MarcinWojewodzic/C2V1_OutDoorWeatherStation/Hardware/PrototymV1_rx/PrototypV1_rx.kicad_pcb

## KiCad design Hardware/PrototymV1_rx/PrototypV1_rx.kicad_pcb (2022-09-23)

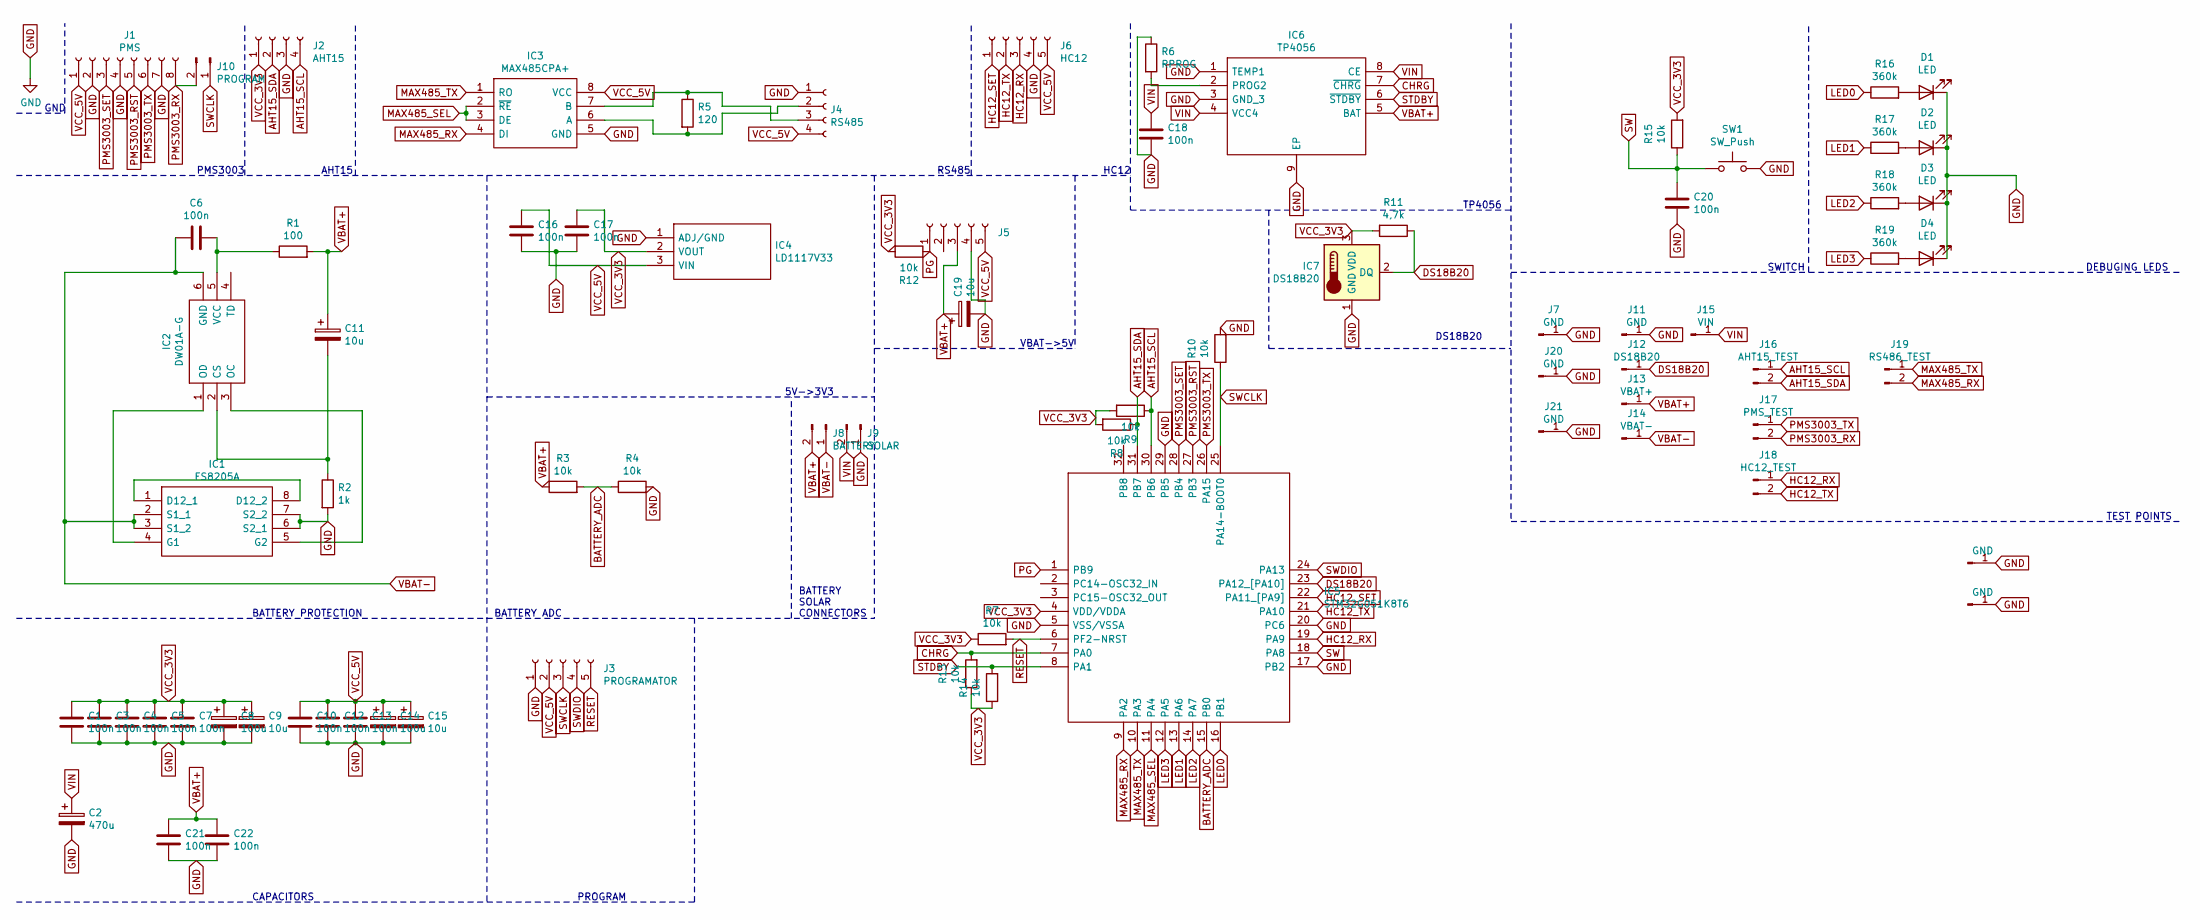
[picture p1: schematic PrototypV1_rx.sch]

Parts:
C1, C3, C4, C5, C6, C7, C10, C12, C13, C16, C17, C18, C20, C21, C22: 100n; C_1206_3216Metric_Pad1.33x1.80mm_HandSolder
C2: 470u; CP_Elec_8x10.5
C8, C14: 100u; CP_Elec_5x5.4
C9, C11, C15, C19: 10u; CP_Elec_4x5.4
D1, D2, D3, D4: LED; D_1206_3216Metric_Pad1.42x1.75mm_HandSolder
IC1: FS8205A; SOP65P640X120-8N; Manufacturer_Part_Number FS8205A
IC2: DW01A-G; SOT95P190X145-6N; Manufacturer_Part_Number DW01A-G
IC3: MAX485CPA+; DIP794W56P254L938H457Q8N; Manufacturer_Part_Number MAX485CPA+; Mouser Part Number 700-MAX485CPA
IC4: LD1117V33; TO255P460X1020X2008-3P; Manufacturer_Part_Number LD1117V33; Mouser Part Number 511-LD1117V33
IC5: STM32G051K8T6; QFP80P900X900X160-32N; Manufacturer_Part_Number STM32G051K8T6; Mouser Part Number 511-STM32G051K8T6
IC6: TP4056; SOIC127P600X175-9N; Manufacturer_Part_Number TP4056
IC7: DS18B20; TO-92_Inline
J1: PMS; PinHeader_1x08_P2.54mm_Vertical
J2: AHT15; PinHeader_1x04_P1.27mm_Horizontal
J3: PROGRAMATOR; PinHeader_1x05_P2.54mm_Vertical
J4: RS485; TerminalBlock_bornier-4_P5.08mm
J5: PinHeader_1x05_P2.54mm_Vertical
J6: HC12; PinHeader_1x05_P2.54mm_Vertical
J7, J11, J20, J21, J23: GND; PinHeader_1x01_P2.54mm_Vertical
J8: BATTERY; PinHeader_1x02_P2.54mm_Vertical
J9: SOLAR; PinHeader_1x02_P2.54mm_Vertical
J10: PROGRAM; PinHeader_1x02_P2.54mm_Vertical
J12: DS18B20; PinHeader_1x01_P2.54mm_Vertical
J13: VBAT+; PinHeader_1x01_P2.54mm_Vertical
J14: VBAT-; PinHeader_1x01_P2.54mm_Vertical
J15: VIN; PinHeader_1x01_P2.54mm_Vertical
J16: AHT15_TEST; PinHeader_1x02_P2.54mm_Vertical
J17: PMS_TEST; PinHeader_1x02_P2.54mm_Vertical
J18: HC12_TEST; PinHeader_1x02_P2.54mm_Vertical
J19: RS486_TEST; PinHeader_1x02_P2.54mm_Vertical
R1: 100; R_1206_3216Metric_Pad1.30x1.75mm_HandSolder
R2: 1k; R_1206_3216Metric_Pad1.30x1.75mm_HandSolder
R3, R4, R7, R8, R9, R10, R12, R13, R14, R15: 10k; R_1206_3216Metric_Pad1.30x1.75mm_HandSolder
R5: 120; R_1206_3216Metric_Pad1.30x1.75mm_HandSolder
R6: RPROG; R_Axial_DIN0309_L9.0mm_D3.2mm_P15.24mm_Horizontal
R11: 4,7k; R_1206_3216Metric_Pad1.30x1.75mm_HandSolder
R16, R17, R18, R19: 360k; R_1206_3216Metric_Pad1.30x1.75mm_HandSolder
SW1: SW_Push; SW_Push_1P1T_NO_6x6mm_H9.5mm
ghj1: GND; PinHeader_1x01_P2.54mm_Vertical

Connections:
AHT15_SCL: IC5.30 (PB6), J2.4, J16.1, R9.1
AHT15_SDA: IC5.31 (PB7), J2.2, J16.2, R8.1
BATTERY_ADC: IC5.15 (PB0), R3.2, R4.1
CHRG: IC5.7 (PA0), IC6.7 (~CHRG), R13.2
DS18B20: IC5.23 (PA12_[PA10]), IC7.2 (DQ), J12.1, R11.1
GND: C1.2, C2.2, C3.2, C4.2, C5.2, C7.2, C8.2, C9.2, C10.2, C12.2, C13.2, C14.2, C15.2, C16.2, C17.2, C18.2, C19.2, C20.2, C21.2, C22.2, D1.1 (K), D2.1 (K), D3.1 (K), D4.1 (K), IC1.6 (S2_1), IC1.7 (S2_2), IC3.5 (GND), IC4.1 (ADJ/GND), IC5.5 (VSS/VSSA), IC5.17 (PB2), IC5.20 (PC6), IC5.29 (PB5), IC6.1 (TEMP1), IC6.3 (GND_3), IC6.9 (EP), IC7.1 (GND), J1.2, J1.4, J1.7, J2.3, J3.1, J4.1, J5.4, J6.4, J7.1, J9.1, J11.1, J20.1, J21.1, J23.1, R2.2, R4.2, R6.1, R10.2, SW1.2, ghj1.1
HC12_RX: IC5.19 (PA9), J6.3, J18.1
HC12_SET: IC5.22 (PA11_[PA9]), J6.1
HC12_TX: IC5.21 (PA10), J6.2, J18.2
LED0: IC5.16 (PB1), R16.1
LED1: IC5.13 (PA6), R17.1
LED2: IC5.14 (PA7), R18.1
LED3: IC5.12 (PA5), R19.1
MAX485_RX: IC3.4 (DI), IC5.9 (PA2), J19.2
MAX485_SEL: IC3.2 (~RE), IC3.3 (DE), IC5.11 (PA4)
MAX485_TX: IC3.1 (RO), IC5.10 (PA3), J19.1
unnamed: C6.2, IC2.5 (VCC), R1.1
unnamed: C11.2, IC2.2 (CS), R2.1
unnamed: D1.2 (A), R16.2
unnamed: D2.2 (A), R17.2
unnamed: D3.2 (A), R18.2
unnamed: D4.2 (A), R19.2
unnamed: IC1.1 (D12_1), IC1.8 (D12_2)
unnamed: IC1.4 (G1), IC2.1 (OD)
unnamed: IC1.5 (G2), IC2.3 (OC)
unnamed: IC3.6 (A), J4.2, R5.2
unnamed: IC3.7 (B), J4.3, R5.1
unnamed: IC6.2 (PROG2), R6.2
PG: IC5.1 (PB9), J5.1, R12.1
PMS3003_RST: IC5.27 (PB3), J1.5
PMS3003_RX: J1.8, J10.2, J17.2
PMS3003_SET: IC5.28 (PB4), J1.3
PMS3003_TX: IC5.26 (PA15), J1.6, J17.1
RESET: IC5.6 (PF2-NRST), J3.5, R7.2
STDBY: IC5.8 (PA1), IC6.6 (~STDBY), R14.2
SW: C20.1, IC5.18 (PA8), R15.1, SW1.1
SWCLK: IC5.25 (PA14-BOOT0), J3.3, J10.1, R10.1
SWDIO: IC5.24 (PA13), J3.4
VBAT+: C11.1, C19.1, C21.1, C22.1, IC6.5 (BAT), J5.3, J8.2, J13.1, R1.2, R3.1
VBAT-: C6.1, IC1.2 (S1_1), IC1.3 (S1_2), IC2.6 (GND), J8.1, J14.1
VCC_3V3: C1.1, C3.1, C4.1, C5.1, C7.1, C8.1, C9.1, C17.1, IC4.2 (VOUT), IC5.4 (VDD/VDDA), IC7.3 (VDD), J2.1, R7.1, R8.2, R9.2, R11.2, R12.2, R13.1, R14.1, R15.2
VCC_5V: C10.1, C12.1, C13.1, C14.1, C15.1, C16.1, IC3.8 (VCC), IC4.3 (VIN), J1.1, J3.2, J4.4, J5.5, J6.5
VIN: C2.1, C18.1, IC6.4 (VCC4), IC6.8 (CE), J9.2, J15.1

Notes on the sheet:
GND
PMS3003
AHT15
RS485
HC12
TP4056
BATTERY PROTECTION
5V->3V3
VBAT->5V
BATTERY ADC
CAPACITORS
PROGRAM
DS18B20
BATTERY SOLAR CONNECTORS
SWITCH
DEBUGING LEDS
TEST POINTS

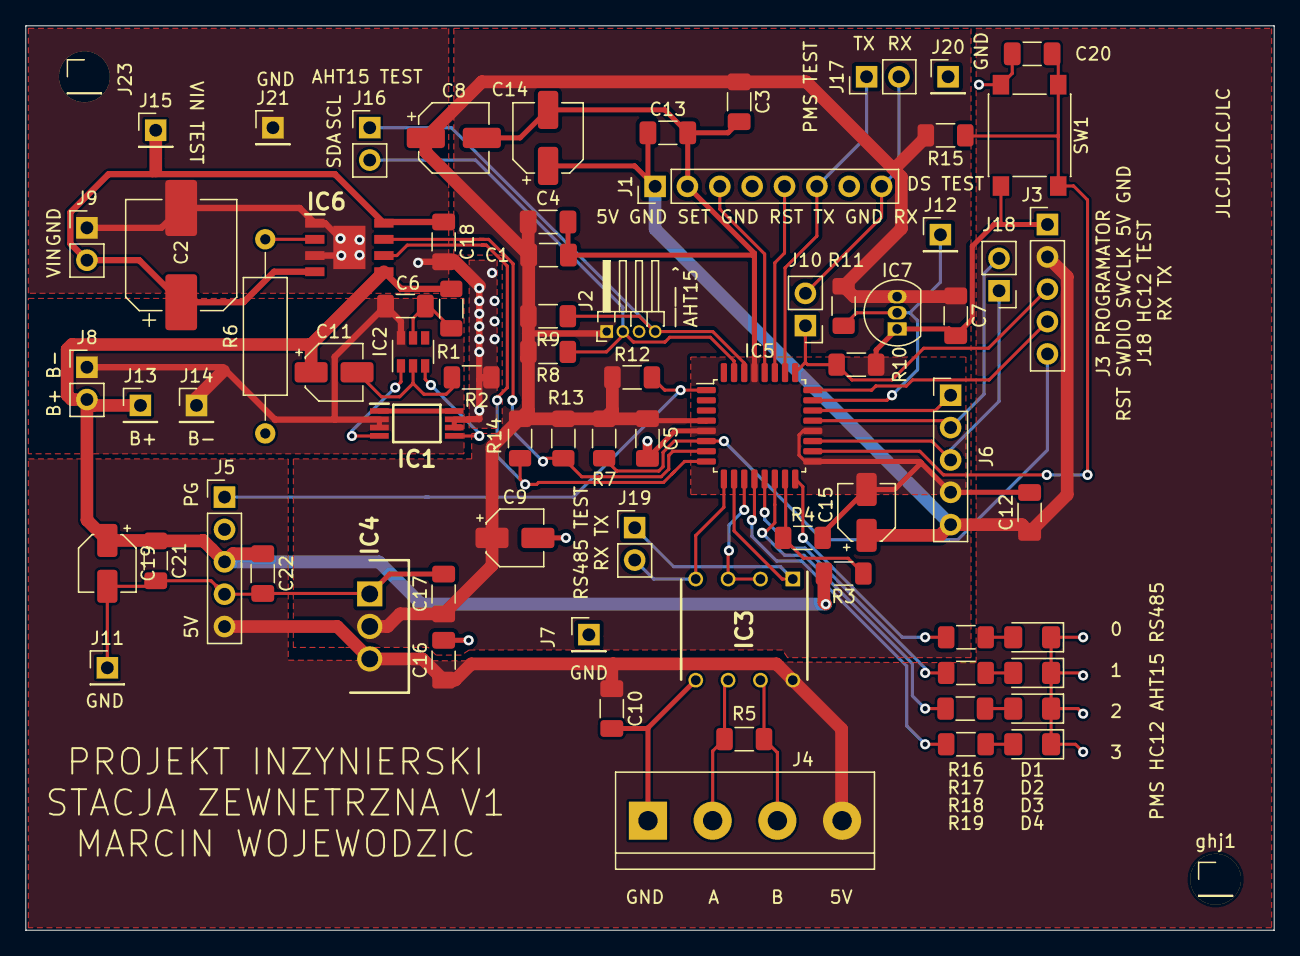
[picture p2: board PrototypV1_rx.kicad_pcb from above]

Board: 2 copper layers, 98.0 x 71.0 mm, 76 parts (0 on the bottom side), 43 nets.
