MarcinWojewodzic/C2V1_OutDoorWeatherStation/Firmware/C2V1_OutDoorWeatherStation/C2V1_OutDoorWeatherStation.ioc

Mcu.UserName=STM32G051K8Tx
PA0.GPIO_Label=BATTERY_CHRG
PA0.Signal=GPIO_Input
PA1.GPIO_Label=BATTERY_STDBY
PA1.Signal=GPIO_Input
PA10.Signal=USART1_RX
PA14-BOOT0.Signal=USART2_TX
PA15.Signal=USART2_RX
PA2.Signal=LPUART1_TX
PA3.Signal=LPUART1_RX
PA4.GPIO_Label=MAX485_SEL
PA4.Signal=GPIO_Output
PA5.GPIO_Label=LED3
PA5.Signal=GPIO_Output
PA6.GPIO_Label=LED1
PA6.Signal=GPIO_Output
PA7.GPIO_Label=LED2
PA7.Signal=GPIO_Output
PA8.GPIO_Label=SWITCH
PA8.Signal=GPXTI8
PA9.Signal=USART1_TX
PB0.Signal=ADC1_IN8
PB1.GPIO_Label=LED0
PB1.Signal=GPIO_Output
PB3.GPIO_Label=PMS_RST
PB3.Signal=GPIO_Output
PB4.GPIO_Label=PMS_SET
PB4.Signal=GPIO_Output
PB6.Signal=I2C1_SCL
PB7.Signal=I2C1_SDA
PB9.GPIO_Label=COVERTER_PG
PB9.Signal=GPIO_Input
