MarcinWojewodzic/C2V1_OutDoorWeatherStation/Firmware/C2V1_OutDoorWeatherStation/Core/Inc/main.h

#define COVERTER_PG_Pin GPIO_PIN_9
#define COVERTER_PG_GPIO_Port GPIOB
#define BATTERY_CHRG_Pin GPIO_PIN_0
#define BATTERY_CHRG_GPIO_Port GPIOA
#define BATTERY_STDBY_Pin GPIO_PIN_1
#define BATTERY_STDBY_GPIO_Port GPIOA
#define MAX485_SEL_Pin GPIO_PIN_4
#define MAX485_SEL_GPIO_Port GPIOA
#define LED3_Pin GPIO_PIN_5
#define LED3_GPIO_Port GPIOA
#define LED1_Pin GPIO_PIN_6
#define LED1_GPIO_Port GPIOA
#define LED2_Pin GPIO_PIN_7
#define LED2_GPIO_Port GPIOA
#define LED0_Pin GPIO_PIN_1
#define LED0_GPIO_Port GPIOB
#define SWITCH_Pin GPIO_PIN_8
#define SWITCH_GPIO_Port GPIOA
#define SWITCH_EXTI_IRQn EXTI4_15_IRQn
#define HC12_SET_Pin GPIO_PIN_11
#define HC12_SET_GPIO_Port GPIOA
#define DS18B20_Pin GPIO_PIN_12
#define DS18B20_GPIO_Port GPIOA
#define PMS_RST_Pin GPIO_PIN_3
#define PMS_RST_GPIO_Port GPIOB
#define PMS_SET_Pin GPIO_PIN_4
#define PMS_SET_GPIO_Port GPIOB
