MarcinWojewodzic/C2V1_OutDoorWeatherStation/Firmware/C2V1_OutDoorWeatherStation/Core/Inc/DelayUs.h

/*
 * DelayUs.h
 *
 *  Created on: Oct 23, 2022
 *      Author: M
 */

#ifndef INC_DELAYUS_H_
#define INC_DELAYUS_H_
#include "main.h"
void TIM_DelayUs(uint32_t DelayUs);
void TIM_Init(TIM_HandleTypeDef *tim);
#endif /* INC_DELAYUS_H_ */
