MarcinWojewodzic/C2V1_OutDoorWeatherStation/(commit log)

2022-10-09 Prototyp Sm dla Switch
2023-01-15 Ukończono
    [PrototypV1_rx.sch]
